yonizvida-gif/asic-physical-design-streaming-system/README.md

# ASIC Physical Design - RTL to GDSII

A complete ASIC Physical Design implementation of a dual-clock
SystemVerilog design, taken from RTL through final GDSII using
**OpenLane 2 / OpenROAD** and the **SKY130** open-source PDK.

The project covers synthesis, timing constraints, floorplanning, power
distribution, placement, clock tree synthesis, timing repair, global and
detailed routing, parasitic extraction, multi-corner static timing
analysis, physical verification, and final GDSII generation.

## Final Results

| Metric | Final Result |
|---|---:|
| Technology | SKY130 |
| Standard-Cell Library | SKY130 HD |
| Standard-Cell Instances | 1,838 |
| Sequential Cells | 333 |
| Integrated Clock Gates | 1 |
| Core Utilization | 61.06% |
| Die Area | 36,814.2 um² |
| Standard-Cell Area | 18,630.4 um² |
| Worst Setup Slack | +2.434 ns |
| Worst Hold Slack | +0.088 ns |
| Setup TNS | 0 ns |
| Hold TNS | 0 ns |
| Setup Violations | 0 |
| Hold Violations | 0 |
| Max Slew Violations | 0 |
| Max Capacitance Violations | 0 |
| Magic DRC | 0 violations |
| KLayout DRC | 0 violations |
| Antenna | 0 net / pin violations |
| LVS | Circuits match uniquely |
| Layout XOR | 0 differences |
| Final GDSII | Generated |

## Final Layout

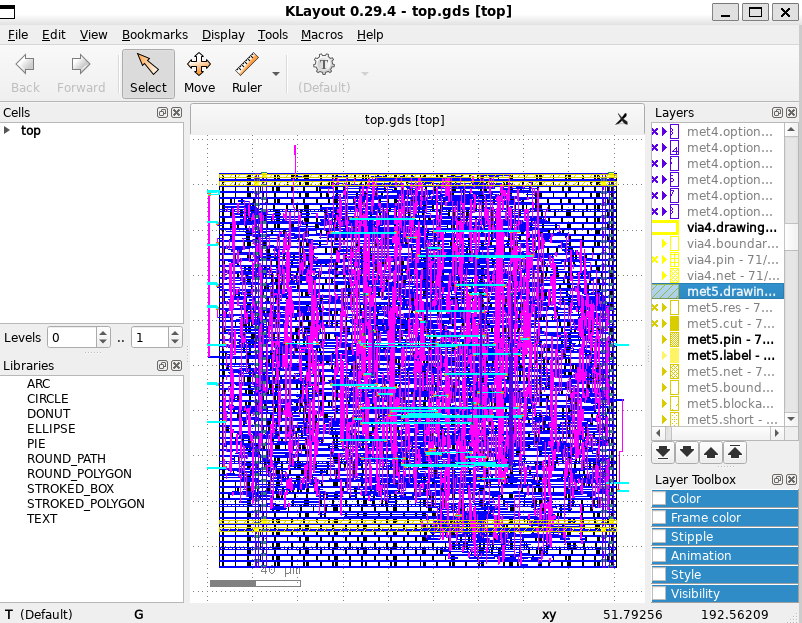
[picture p1: physical_design/images/12_Final_GDS_Metal_Routing.png]
Final GDS Metal Routing


The final routed layout contains the placed standard cells, clock
distribution, power distribution, signal routing, vias, and upper-metal
interconnect generated by the Physical Design flow.

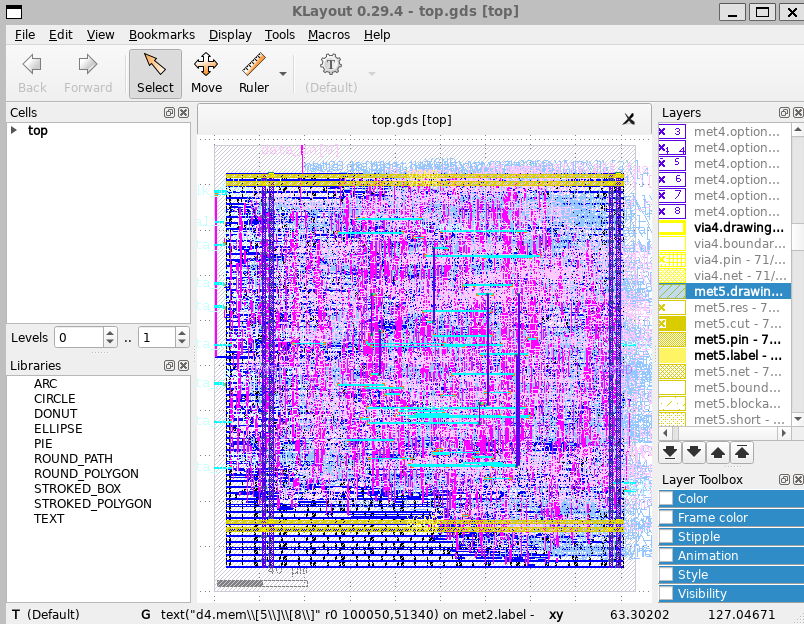
[picture p2: physical_design/images/13_Final_GDS_Full_Layout.png]
Final GDS Full Layout


------------------------------------------------------------------------

## Design Overview

The design is a dual-clock streaming system containing:

-   4-tap FIR filter
-   Asynchronous FIFO for clock-domain crossing
-   UART transmitter
-   Hardware clock gating
-   100 MHz fast clock domain
-   10 MHz slow clock domain

Main data path:

``` text
data_in / valid_in
        |
        v
   Wake-Up Logic
        |
        v
     4-Tap FIR
        |
        v
  Asynchronous FIFO
        |
        v
    UART Transmitter
        |
        v
     tx_serial
```

The FIR operates in the fast clock domain. Filtered samples cross into
the slow clock domain through a Gray-coded asynchronous FIFO with
two-flip-flop pointer synchronizers.

The design contains two intentionally asynchronous clock domains, making
CDC handling and timing constraints an important part of the
implementation.

------------------------------------------------------------------------

## RTL-to-GDSII Flow

``` text
SystemVerilog RTL
        |
        v
     Synthesis
        |
        v
   Floorplanning
        |
        v
 Power Distribution
        |
        v
     Placement
        |
        v
Clock Tree Synthesis
        |
        v
   Timing Repair
        |
        v
   Global Routing
        |
        v
 Detailed Routing
        |
        v
Parasitic Extraction
        |
        v
 Multi-Corner STA
        |
        v
 Physical Signoff
        |
        v
      GDSII
```

The implementation was performed using OpenLane 2 with OpenROAD and the
SKY130 HD standard-cell library.

------------------------------------------------------------------------

## ASIC Clock Gating

The ASIC implementation uses the SKY130 integrated clock-gating cell:

``` text
sky130_fd_sc_hd__dlclkp_1
```

The integrated clock gate provides a technology-appropriate glitch-free
implementation and allows the gated FIR clock to participate correctly
in clock tree synthesis and static timing analysis.

The final design contains one integrated clock-gating cell.

------------------------------------------------------------------------

## Timing Constraints

Two primary clocks are defined:

``` tcl
create_clock -name clk_fast -period 10.000 [get_ports {clk_fast}]
create_clock -name clk_slow -period 100.000 [get_ports {clk_slow}]
```

The two clock domains are declared asynchronous:

``` tcl
set_clock_groups -asynchronous \
    -group [get_clocks {clk_fast}] \
    -group [get_clocks {clk_slow}]
```

Interface assumptions used for the Physical Design implementation:

``` text
Input delay minimum = 0.5 ns
Input delay maximum = 2.0 ns
Clock uncertainty   = 0.2 ns
```

These are portfolio implementation assumptions rather than measured
external-interface specifications.

`rst_n` is an asynchronous reset and is intentionally not modeled as
ordinary synchronous input data.

`tx_serial` is a protocol-driven UART output and is intentionally
excluded from synchronous output timing analysis.

The broad reset false-path approach was intentionally avoided so that
reset-related timing behavior is not silently hidden.

------------------------------------------------------------------------

## Synthesis

The SystemVerilog RTL was synthesized with Yosys as part of the OpenLane
flow and mapped to SKY130 HD standard cells.

Final implementation statistics include:

``` text
Standard-cell instances = 1,838
Sequential cells        = 333
Integrated clock gates  = 1
Macros                   = 0
```

No unmapped cells or inferred latches remained in the final
implementation.

------------------------------------------------------------------------

## Floorplanning and Power Distribution

The final design uses:

``` text
Die dimensions      = 186.585 um x 197.305 um
Die area            = 36,814.2 um²
Standard-cell area  = 18,630.4 um²
Core utilization    = 61.06%
Macros              = 0
```

The design is implemented entirely with standard cells. The generated
power grid completed connectivity checks without reported VPWR or VGND
violations.

------------------------------------------------------------------------

## Placement

Standard cells were placed within the defined core area before clock
tree synthesis and routing.

Placement was followed by optimization and timing-driven repair as the
design progressed through the Physical Design flow.

------------------------------------------------------------------------

## Clock Tree Synthesis

CTS builds physical clock distribution networks for:

-   `clk_fast`
-   `clk_slow`
-   Gated FIR clock

Clock buffers and inverters were inserted to control clock transition,
fanout, latency, and skew.

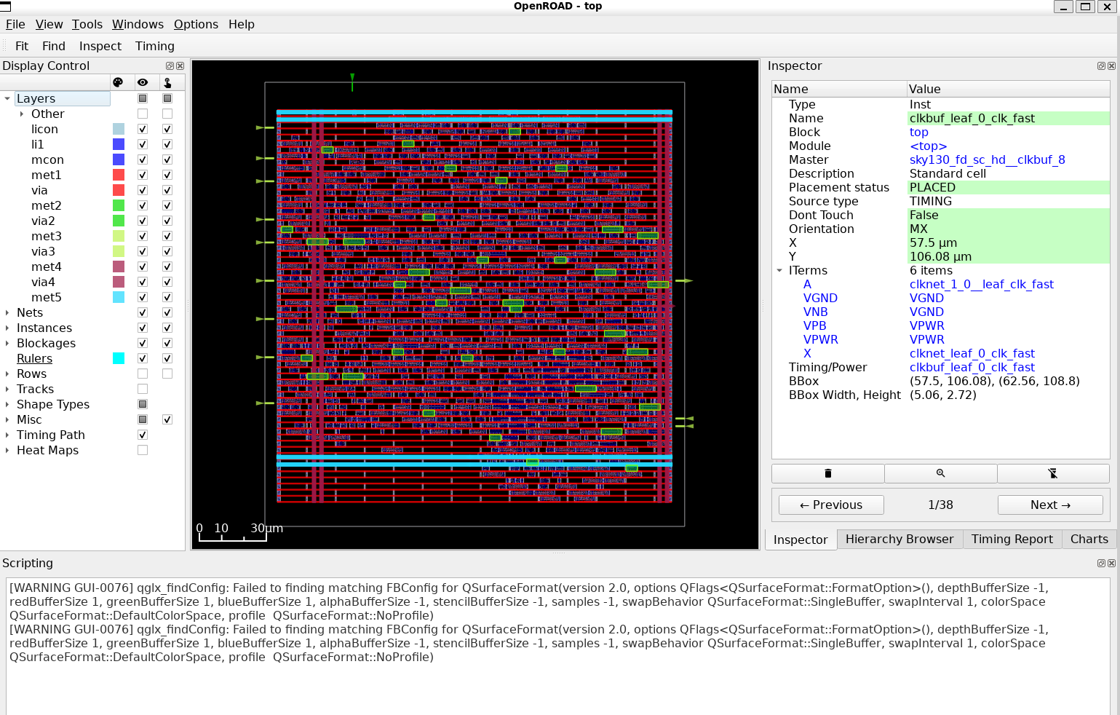
[picture p3: physical_design/images/03_CTS_Clock_Buffers.png]
CTS Clock Buffers


After CTS, hold analysis exposed short data paths that required repair.
Delay buffers were inserted to improve minimum-delay timing while
preserving setup timing.

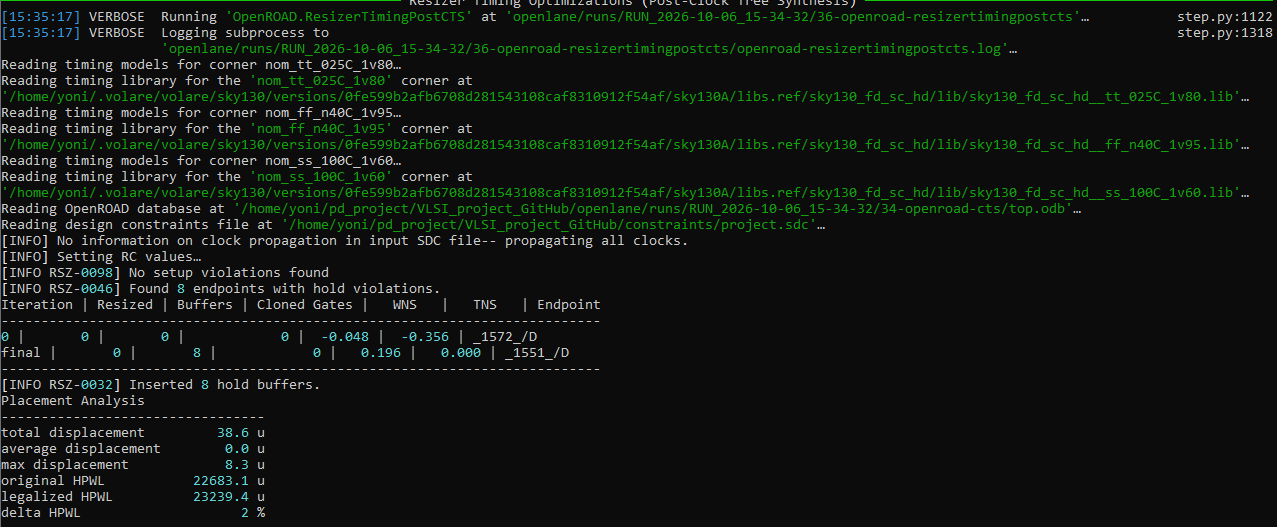
[picture p4: physical_design/images/04_Post-CTS_Hold_Repair.png]
Post-CTS Hold Repair


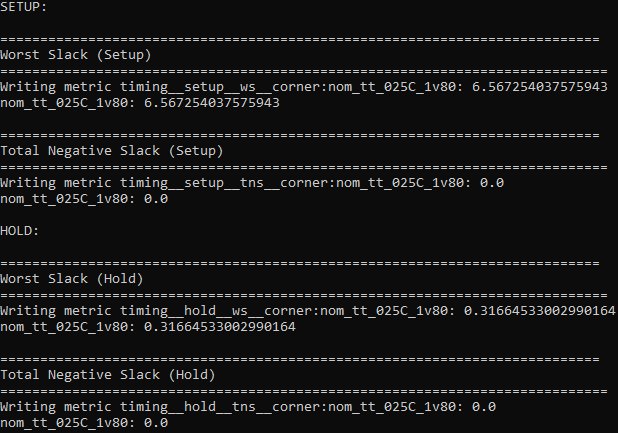
[picture p5: physical_design/images/05_Post-CTS_STA_After_Hold_Repair.png]
Post-CTS STA


------------------------------------------------------------------------

## Global Routing and Congestion

Global routing determines coarse interconnect paths and evaluates
routing-resource demand before exact tracks and vias are assigned.

The routing process completed with zero global-routing overflow.

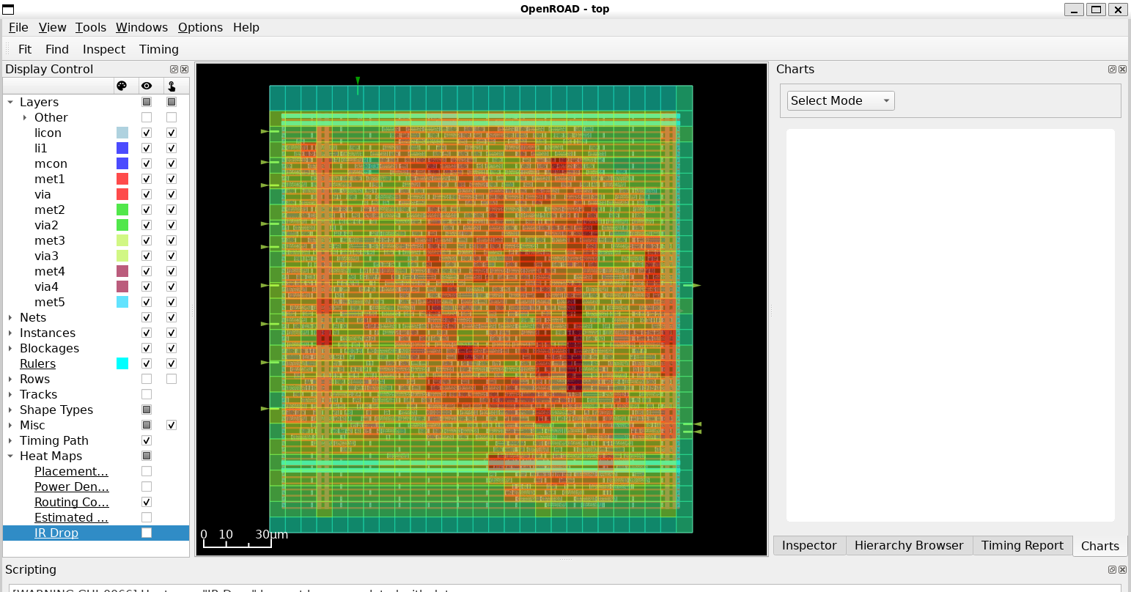
[picture p6: physical_design/images/07_Global_Routing_Congestion_Heatmap.png]
Global Routing Congestion


------------------------------------------------------------------------

## Detailed Routing

Detailed routing assigns exact tracks, metal layers, and vias while
satisfying physical design rules.

Routing-rule violations were iteratively repaired until the detailed
router reached zero remaining violations.

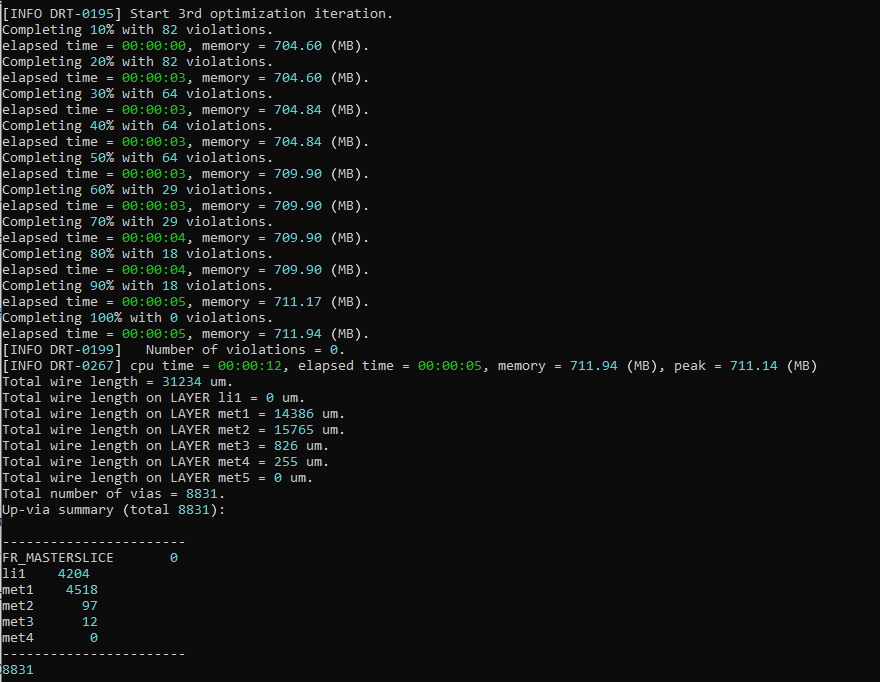
[picture p7: physical_design/images/08_Detailed_Routing_Zero_Violations.png]
Detailed Routing - Zero Violations


### Routed Metal Layers

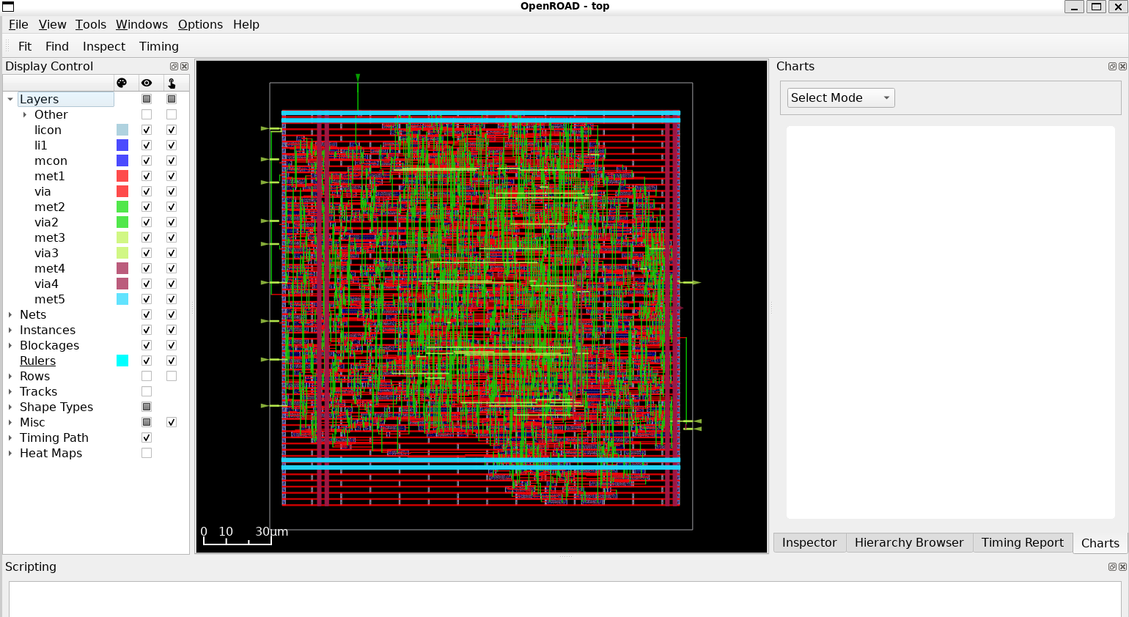
[picture p8: physical_design/images/09_Detailed_Routing_Metal_Layers.png]
Detailed Routing Metal Layers


------------------------------------------------------------------------

## Parasitic Extraction and Post-Route STA

After detailed routing, interconnect resistance and capacitance were
extracted and included in timing analysis.

Post-route timing was evaluated across nine PVT/RC analysis
combinations.

Final worst-case timing:

``` text
Worst Setup Slack = +2.434 ns
Worst Hold Slack  = +0.088 ns

Setup TNS         = 0 ns
Hold TNS          = 0 ns

Setup Violations  = 0
Hold Violations   = 0

Max Slew Violations        = 0
Max Capacitance Violations = 0
```

Worst setup slack occurred in the slow timing corner, while worst hold
slack occurred in the fast timing corner.

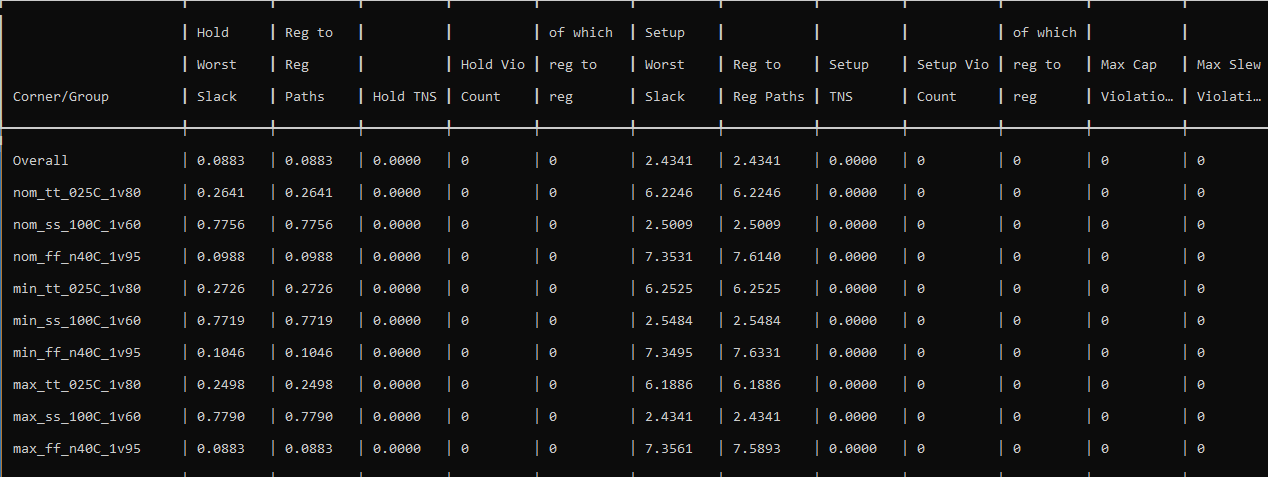
[picture p9: physical_design/images/10_Post_Route_STA_All_Corners.png]
Post-Route Multi-Corner STA


The final STA reports are preserved under:

``` text
physical_design/reports/
```

------------------------------------------------------------------------

## Physical Verification and Signoff

The final routed design completed the implemented signoff checks
successfully.

| Check | Final Result |
|---|---:|
| Magic DRC | 0 violations |
| KLayout DRC | 0 violations |
| Antenna | 0 net / pin violations |
| LVS | Circuits match uniquely |
| Layout XOR | 0 differences |
| Setup Violations | 0 |
| Hold Violations | 0 |
| Max Slew Violations | 0 |
| Max Capacitance Violations | 0 |

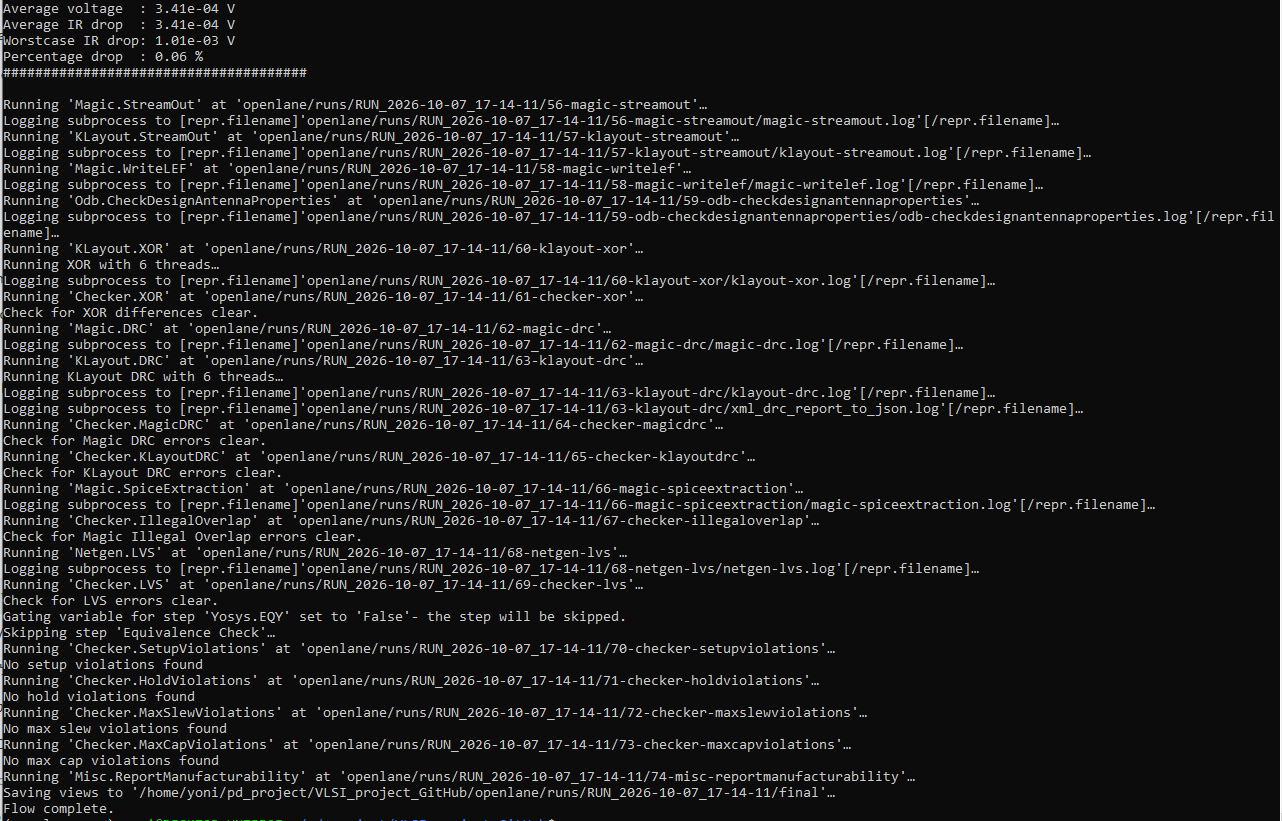
[picture p10: physical_design/images/11_Final_Signoff_Flow_Complete.png]
Final Signoff


Selected signoff reports are available in:

``` text
physical_design/reports/
```

------------------------------------------------------------------------

## Final GDSII

The complete flow produced the final GDSII layout:

``` text
physical_design/final/top.gds
```

### Routed Metal View

Final GDS Metal Routing

### Full Layout View

Final GDS Full Layout

------------------------------------------------------------------------

## Repository Structure

``` text
.
├── constraints/
│   └── project.sdc
│
├── rtl_asic/
│   ├── FIR.sv
│   ├── async_fifo.sv
│   ├── clk_gate.sv
│   ├── power_controller.sv
│   ├── top.sv
│   └── uart_tx.sv
│
├── openlane/
│   └── config.json
│
├── physical_design/
│   ├── final/
│   │   └── top.gds
│   ├── images/
│   └── reports/
│
├── .gitignore
└── README.md
```

Generated OpenLane run directories are intentionally excluded from
version control. Selected final reports, screenshots, configuration
files, ASIC RTL, and the final GDSII are retained as portfolio
artifacts.

------------------------------------------------------------------------

## Tools and Technologies

### Physical Design

-   OpenLane 2
-   OpenROAD
-   SKY130 PDK
-   SKY130 HD standard-cell library
-   Yosys
-   OpenSTA
-   KLayout
-   Magic
-   Netgen

### Design and Constraints

-   SystemVerilog
-   Tcl
-   SDC
-   Static Timing Analysis
-   Multi-clock timing
-   Multi-corner timing analysis
-   Clock Domain Crossing
-   Integrated clock gating

------------------------------------------------------------------------

## Engineering Topics Demonstrated

-   RTL-to-GDSII implementation
-   Synthesis and technology mapping
-   SDC timing constraints
-   Static Timing Analysis
-   Setup and hold analysis
-   Asynchronous clock-domain constraints
-   Gray-code asynchronous FIFO CDC
-   Floorplanning
-   Power distribution
-   Standard-cell placement
-   Clock Tree Synthesis
-   Integrated clock gating
-   Hold-time repair
-   Global routing
-   Congestion analysis
-   Detailed routing
-   Parasitic extraction
-   Post-route multi-corner STA
-   Timing closure
-   DRC
-   LVS
-   Antenna checking
-   Layout XOR verification
-   GDSII generation

------------------------------------------------------------------------

## Reproducing the Flow

The OpenLane configuration is provided in:

``` text
openlane/config.json
```

The timing constraints are provided in:

``` text
constraints/project.sdc
```

The ASIC RTL is provided in:

``` text
rtl_asic/
```

With OpenLane 2 and the required SKY130 PDK environment installed, the
project can be used to reproduce the RTL-to-GDSII implementation flow.

------------------------------------------------------------------------

## Summary

This project demonstrates a complete ASIC Physical Design flow from
SystemVerilog RTL to final GDSII using OpenLane/OpenROAD and SKY130.

The implementation reached post-route timing closure with positive setup
and hold slack across the analyzed timing corners and completed DRC,
LVS, antenna, and layout XOR verification successfully.

``` text
Worst Setup Slack   = +2.434 ns
Worst Hold Slack    = +0.088 ns
Setup TNS           = 0 ns
Hold TNS            = 0 ns
DRC Violations      = 0
Antenna Violations  = 0
LVS                 = Clean
XOR Differences     = 0
Final GDSII         = Generated
```
