yonizvida-gif/asic-physical-design-streaming-system/physical_design/images/01_Pre-PnR_STA_No_Violations.png

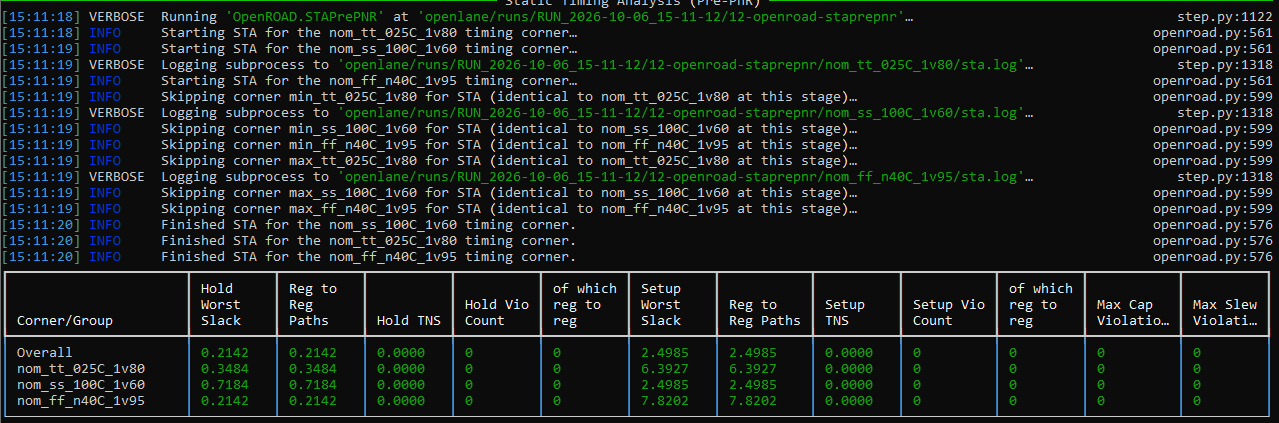
physical_design/images/01_Pre-PnR_STA_No_Violations.png
