yonizvida-gif/asic-physical-design-streaming-system/physical_design/images/02_Mid-PnR_STA_Pre-CTS.png

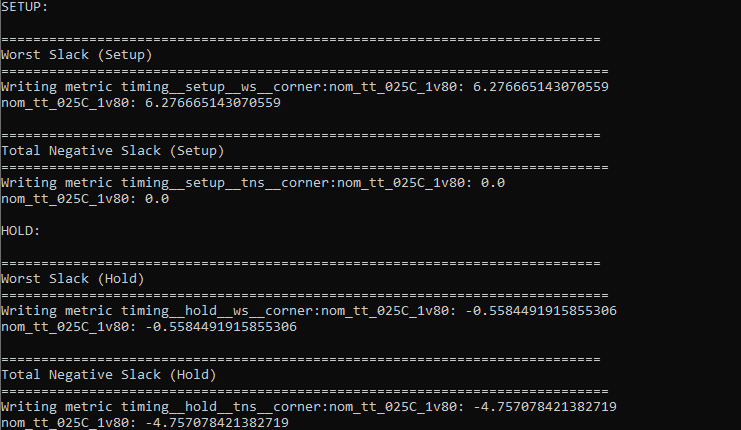
physical_design/images/02_Mid-PnR_STA_Pre-CTS.png
