yonizvida-gif/asic-physical-design-streaming-system/physical_design/images/06_Global_Routing_Congestion_Report.png

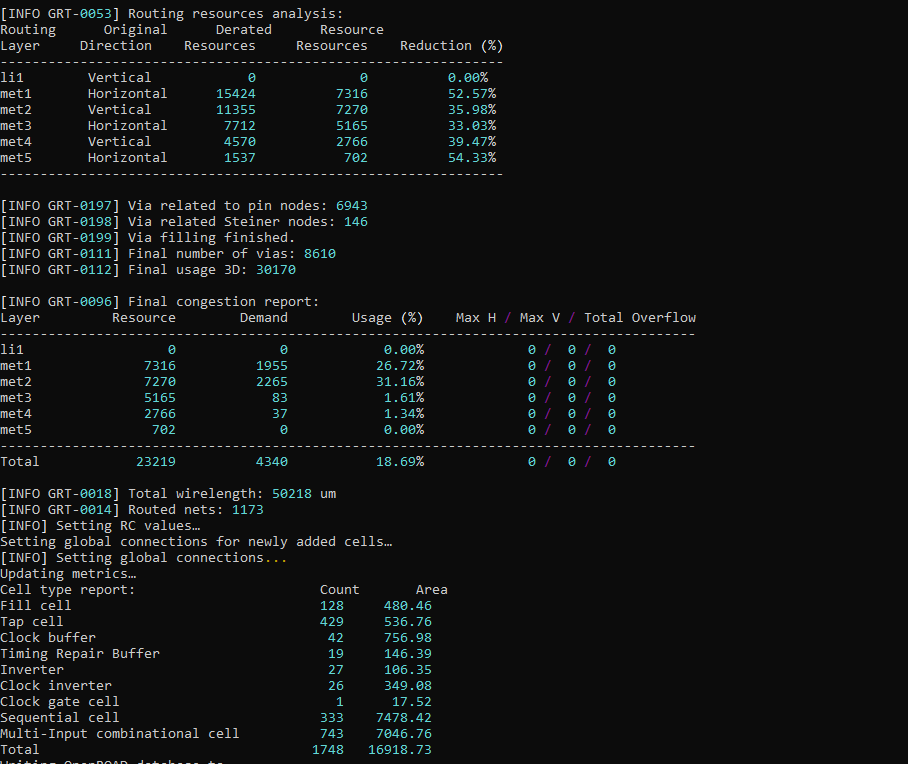
physical_design/images/06_Global_Routing_Congestion_Report.png
