yonizvida-gif/asic-physical-design-streaming-system/rtl_asic/clk_gate.sv

module clk_gate (
    input  logic inclk,
    input  logic ena,
    output logic outclk
);

    sky130_fd_sc_hd__dlclkp_1 u_icg (
        .CLK  (inclk),
        .GATE (ena),
        .GCLK (outclk)
    );

endmodule
